joelwright-dev/nixie-clock/Assembly/SMT026051760500_B_02001476_20260529062730.jpg

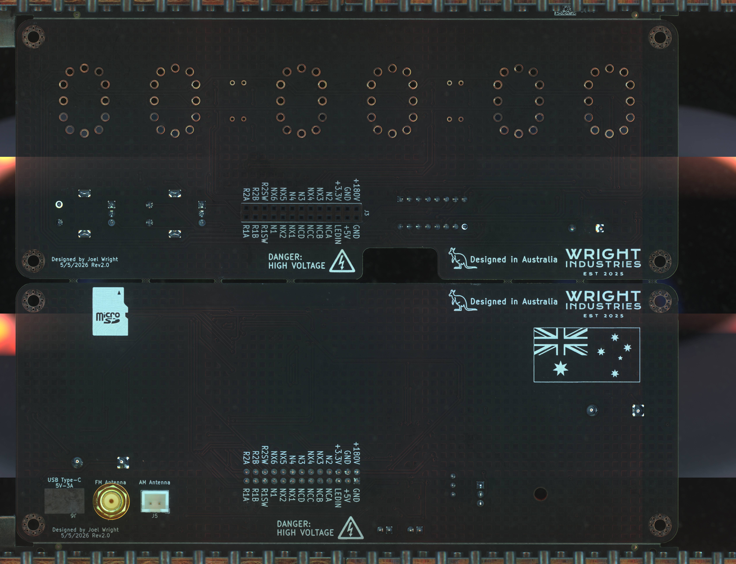
Assembly/SMT026051760500_B_02001476_20260529062730.jpg
