joelwright-dev/nixie-clock/Assembly/SMT026051760500_T_02001476_20260529062728.jpg

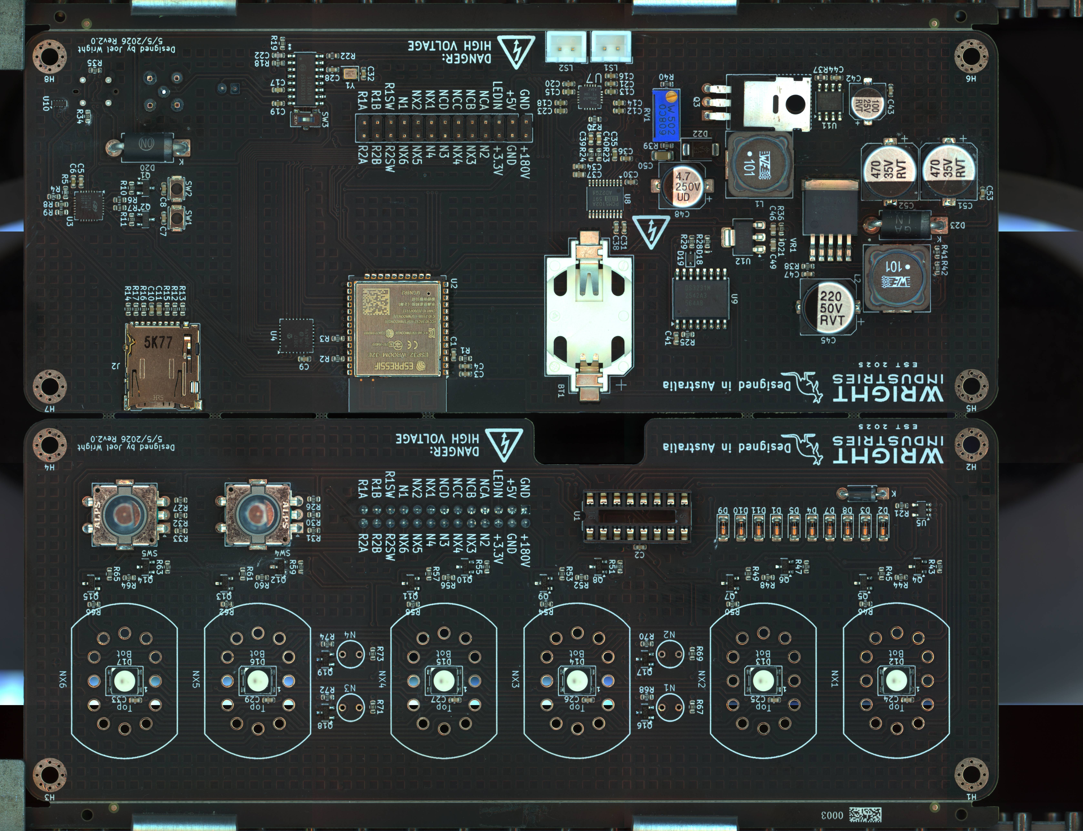
Assembly/SMT026051760500_T_02001476_20260529062728.jpg
