joelwright-dev/nixie-clock/esp32-devkitc-v4_reference_design/ESP32-DevKitC-V4_Reference_Design/README.pdf

请使⽤用以下⼯工具打开原理理图和 PCB ⽂文件 / Use the following tools to open schematics and PCB files: SCH: Cadence/OrCAD Capture V16.6
PCB: Mentor Graphics/Pads VⅩ.2

修订历史 / Revision History

- 2018.06
- 更更新原理理图和 BOM，移除 C15。更更多信息请查看 ESP32-DevKitC ⼊入⻔门指南。/ (http://esp-idf.readthedocs.io/en/latest/get-started/get-started-devkitc.html) Removed C15 from schematics and BOM list. More information can be found in ESP32-DevKitC Getting Started Guide.) (http://esp-idf.readthedocs.io/en/latest/get-started/get-started-devkitc.html)
- 增加针对 ESP32-WROOM-32D、ESP32-WROOM-32U 和 ESP32-SOLO-1 模组的 BOM。/ Added the BOM lists for modules ESP32-WROOM-32D, ESP32-WROOM-32U and ESP32-SOLO-1.
- 2018.01
- ⾸首次发布。/
First release.
