joelwright-dev/nixie-clock/SnapEDA/MAX3421EETJ_T/MAX3421EETJ_T.step

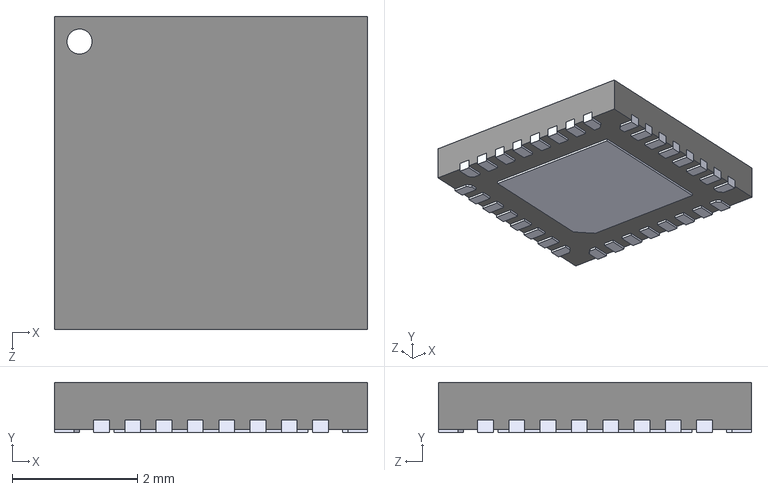
[picture p3: CAD file, 2026-06-27]
SnapEDA/MAX3421EETJ_T/MAX3421EETJ_T.step
5.00 x 0.8 x 5.00 mm
