joelwright-dev/nixie-clock/SnapEDA/TPA2016D2RTJR/TPA2016D2RTJR.step

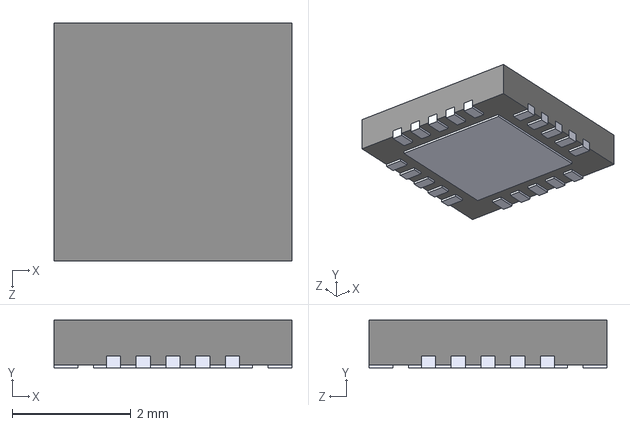
[picture p4: CAD file, 2026-04-03]
SnapEDA/TPA2016D2RTJR/TPA2016D2RTJR.step
4.00 x 0.8 x 4.00 mm
