joelwright-dev/nixie-clock/mostlydone.pdf

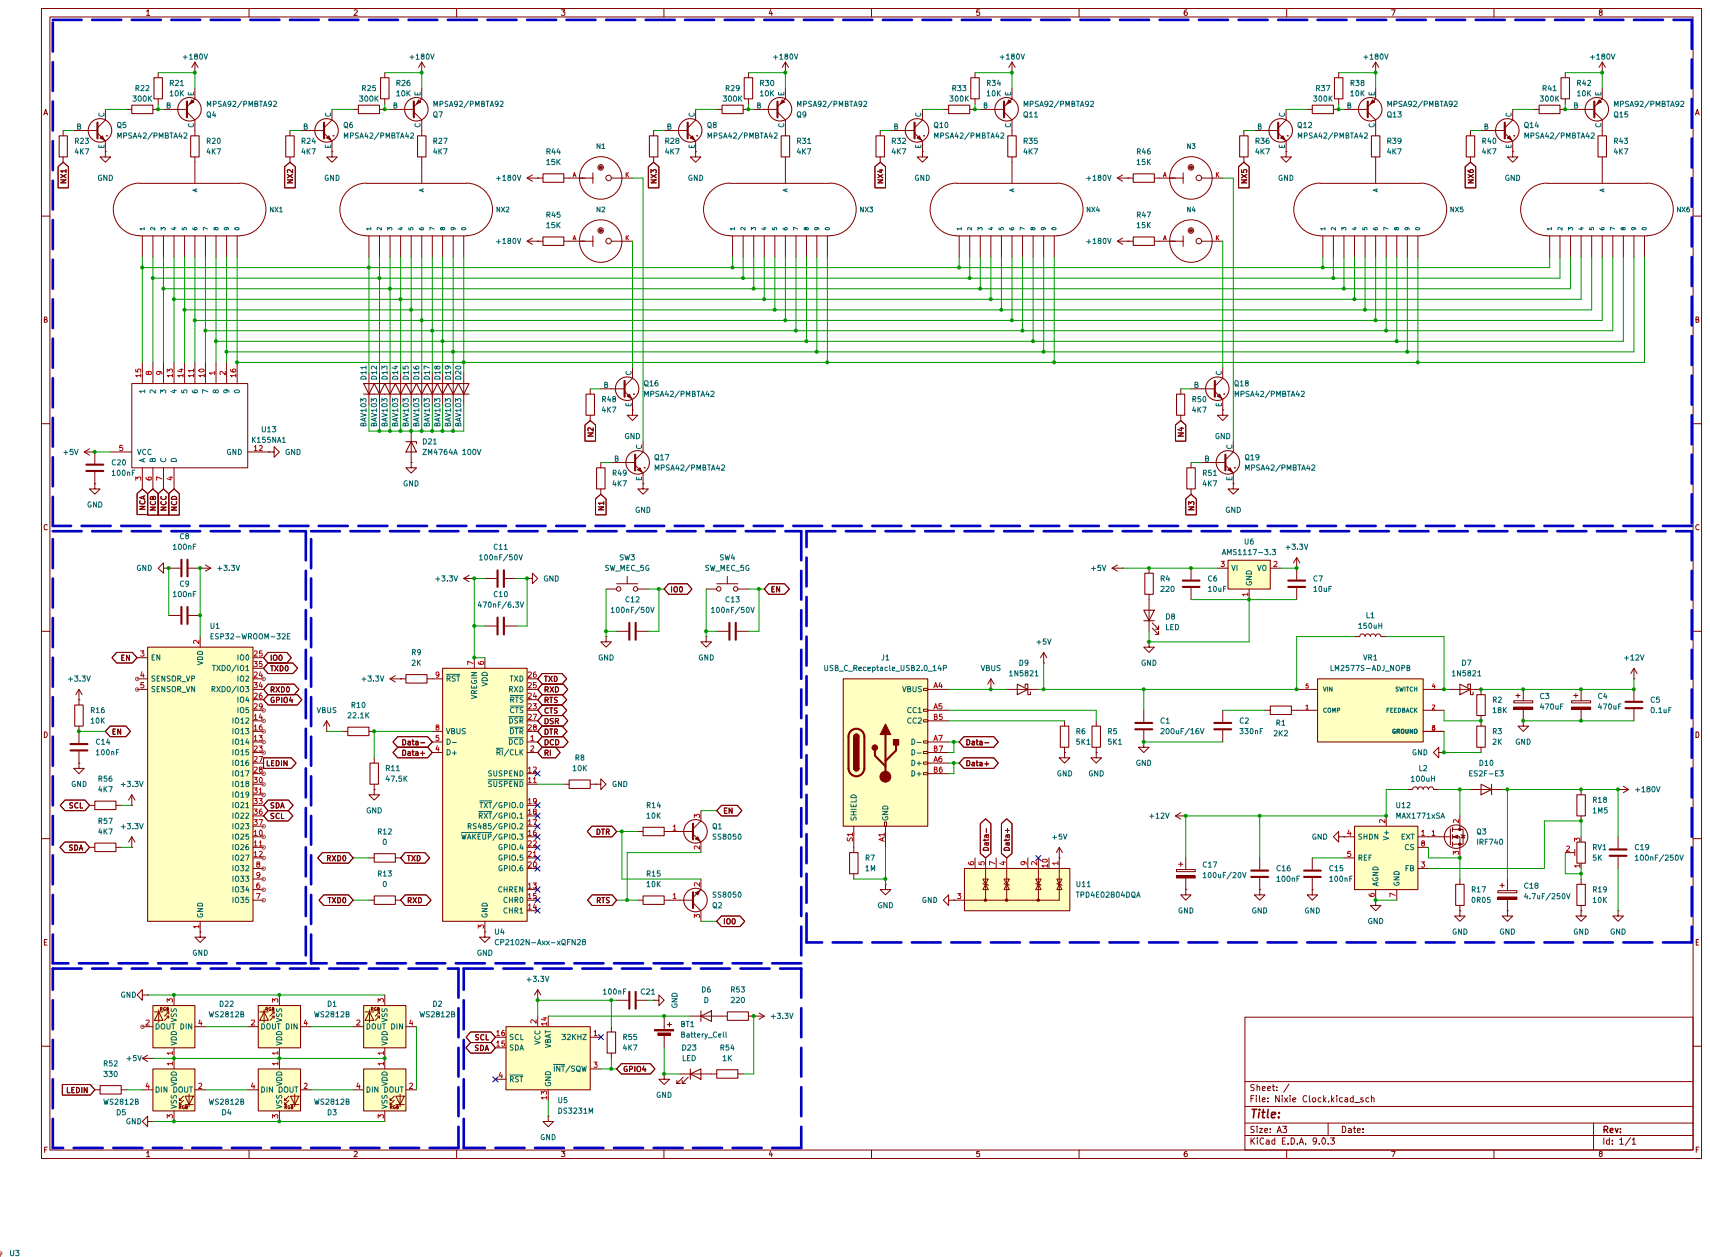
[picture p14: page 1]
