joelwright-dev/nixie-clock/(list of files, drawings)

Other design files:
esp32-devkitc-v4_reference_design/ESP32-DevKitC-V4_Reference_Design/02_PCB Layout/ESP32-DevKitC-V4_20171206A.pcb
