joelwright-dev/nixie-clock/Nixie Clock/Nixie Clock.kicad_pcb

## KiCad design Nixie Clock/Nixie Clock.kicad_pcb (2026-05-05)

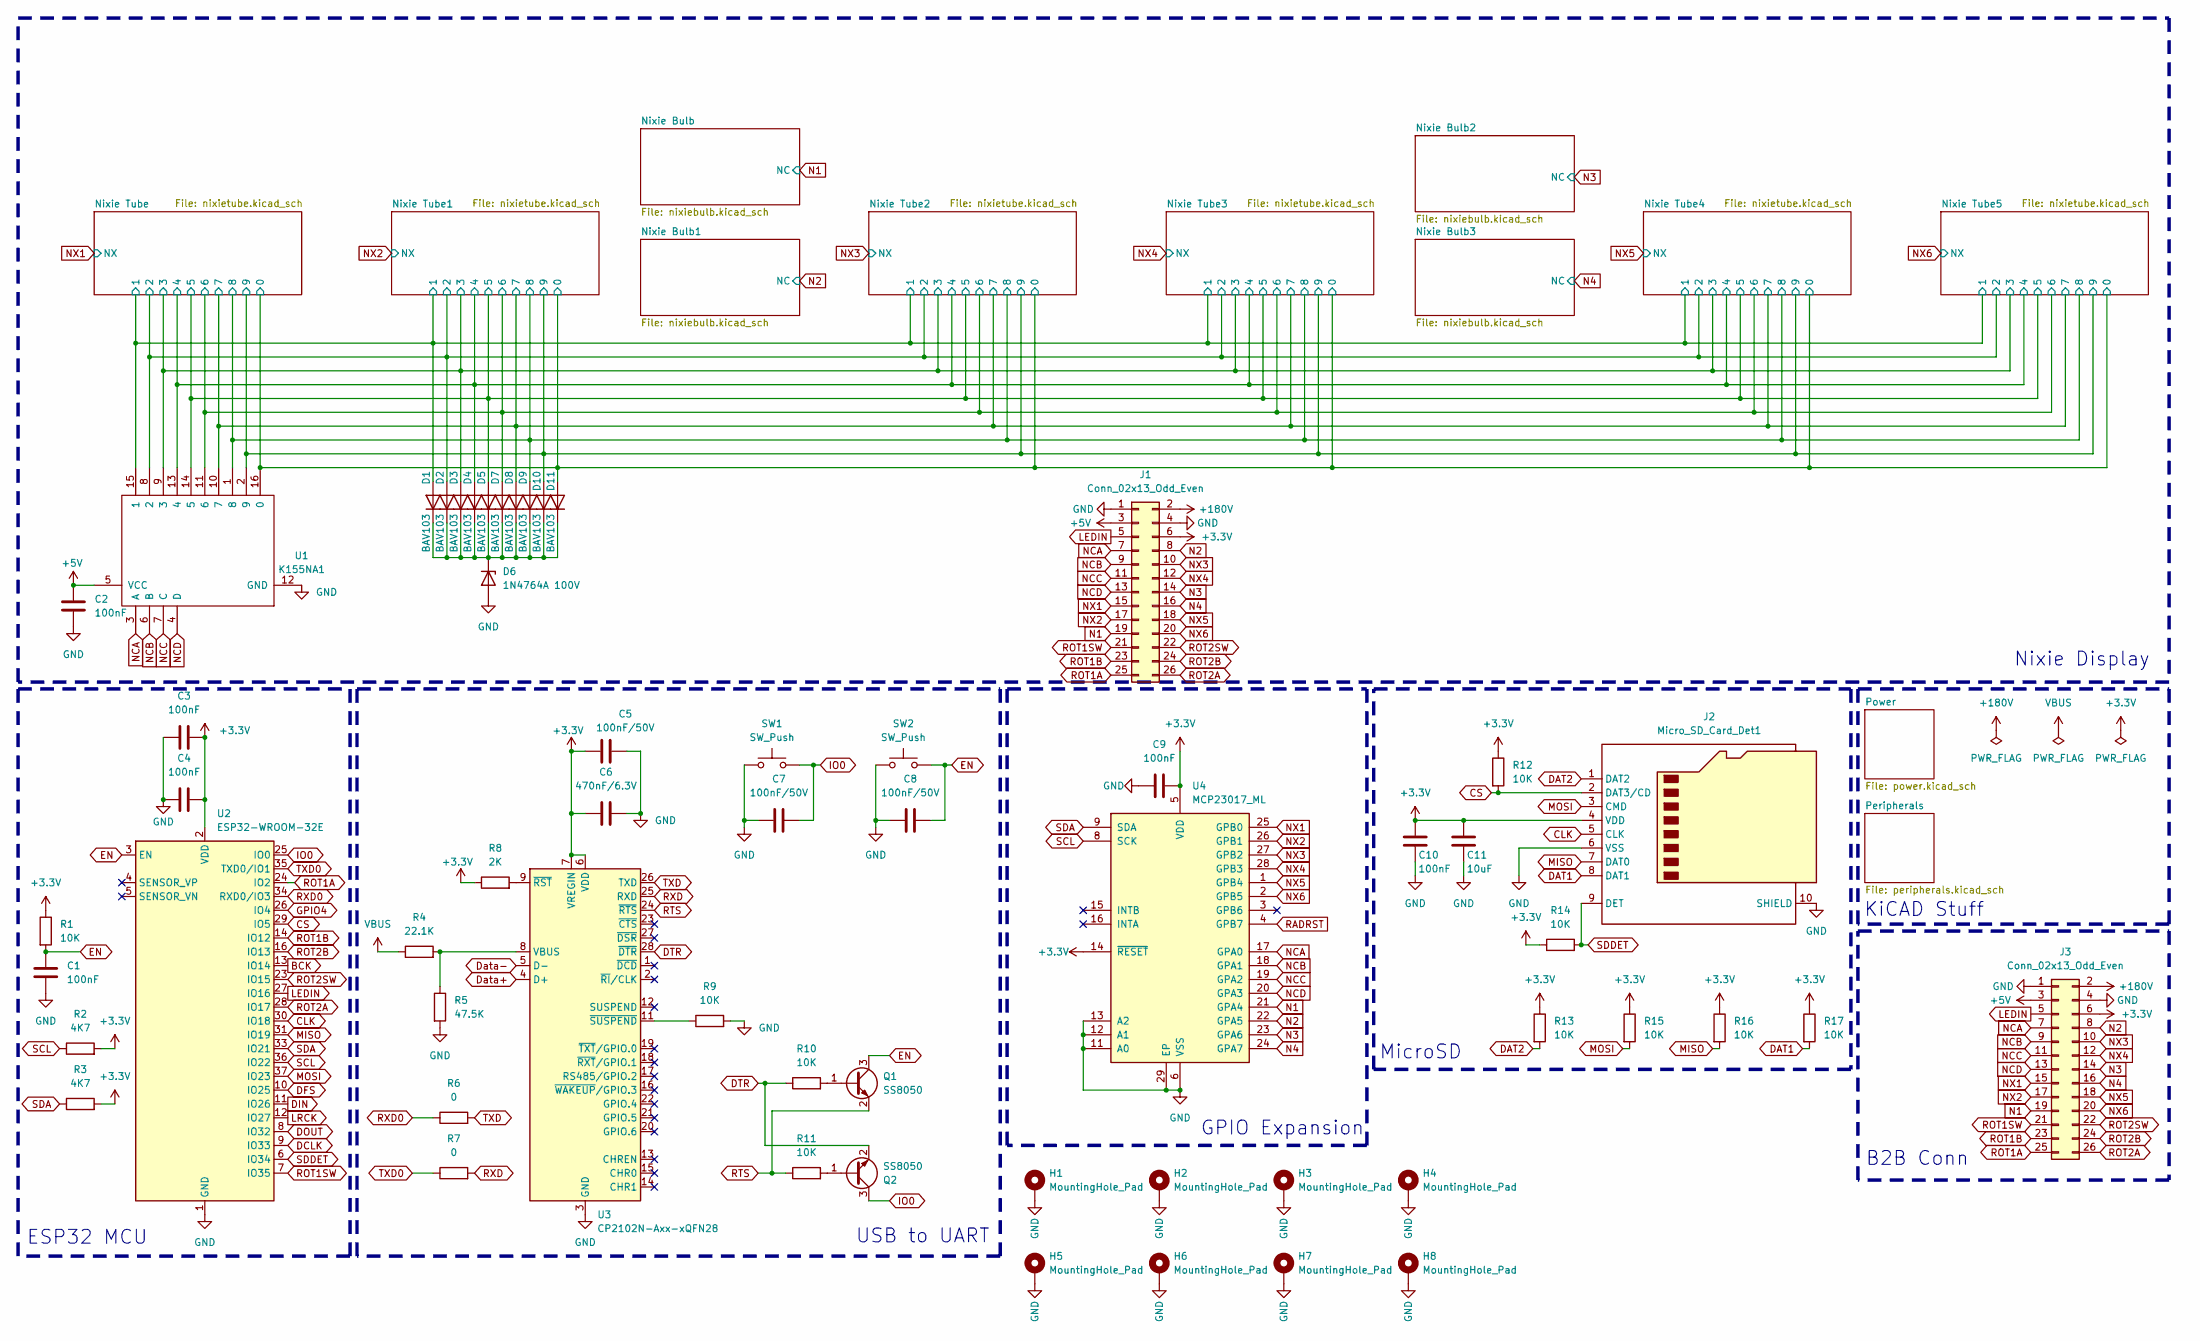
[picture p15: schematic Nixie Clock.kicad_sch]

Parts:
C1, C2, C3, C4, C9, C10: 100nF; C_0603_1608Metric
C5, C7, C8: 100nF/50V; C_0603_1608Metric
C6: 470nF/6.3V; C_0603_1608Metric
C11: 10uF; C_0603_1608Metric
D1, D2, D3, D4, D5, D7, D8, D9, D10, D11: BAV103; D_MiniMELF
D6: 1N4764A 100V; D_DO-41_SOD81_P7.62mm_Horizontal
H1, H2, H3, H4, H5, H6, H7, H8: MountingHole_Pad; MountingHole_3.2mm_M3_Pad_Via
J1: Conn_02x13_Odd_Even; PinHeader_2x13_P2.54mm_Vertical
J2: Micro_SD_Card_Det1; microSD_HC_Hirose_DM3AT-SF-PEJM5
J3: Conn_02x13_Odd_Even; PinSocket_2x13_P2.54mm_Vertical
Q1, Q2: SS8050; SOT-23
R1, R9, R10, R11, R12, R13, R14, R15, R16, R17: 10K; R_0603_1608Metric
R2, R3: 4K7; R_0603_1608Metric
R4: 22.1K; R_0603_1608Metric
R5: 47.5K; R_0603_1608Metric
R6, R7: 0; R_0603_1608Metric
R8: 2K; R_0603_1608Metric
SW1, SW2: SW_Push; SW_Push_SPST_NO_Alps_SKRK
U1: K155NA1; DIP-16_W7.62mm
U2: ESP32-WROOM-32E; ESP32-WROOM-32D
U3: CP2102N-Axx-xQFN28; QFN-28-1EP_5x5mm_P0.5mm_EP3.35x3.35mm
U4: MCP23017_ML; QFN-28-1EP_6x6mm_P0.65mm_EP4.25x4.25mm

Connections:
+3.3V: C3.2, C4.2, C5.1, C6.1, C9.2, C10.1, C11.1, J1.6, J2.4 (VDD), J3.6, R1.1, R2.2, R3.2, R8.1, R12.1, R13.1, R14.1, R15.1, R16.1, R17.1, U2.2 (VDD), U3.6 (VDD), U3.7 (VREGIN), U4.5 (VDD), U4.14 (~RESET); also elsewhere on the board
+5V: C2.1, J1.3, J3.3, U1.5 (VCC); also elsewhere on the board
+180V: J1.2, J3.2; also elsewhere on the board
/Nixie Tube/0: D11.2 (A), U1.16 (0); also elsewhere on the board
/Nixie Tube/1: D1.2 (A), U1.15 (1); also elsewhere on the board
/Nixie Tube/2: D2.2 (A), U1.8 (2); also elsewhere on the board
/Nixie Tube/3: D3.2 (A), U1.9 (3); also elsewhere on the board
/Nixie Tube/4: D4.2 (A), U1.13 (4); also elsewhere on the board
/Nixie Tube/5: D5.2 (A), U1.14 (5); also elsewhere on the board
/Nixie Tube/6: D7.2 (A), U1.11 (6); also elsewhere on the board
/Nixie Tube/7: D8.2 (A), U1.10 (7); also elsewhere on the board
/Nixie Tube/8: D9.2 (A), U1.1 (8); also elsewhere on the board
/Nixie Tube/9: D10.2 (A), U1.2 (9); also elsewhere on the board
BCK: U2.13 (IO14); also elsewhere on the board
CLK: J2.5 (CLK), U2.30 (IO18)
CS: J2.2 (DAT3/CD), R12.2, U2.29 (IO5)
DAT1: J2.8 (DAT1), R17.2
DAT2: J2.1 (DAT2), R13.2
DCLK: U2.9 (IO33); also elsewhere on the board
DFS: U2.10 (IO25); also elsewhere on the board
DIN: U2.11 (IO26); also elsewhere on the board
DOUT: U2.8 (IO32); also elsewhere on the board
DTR: Q2.2 (E), R10.1, U3.28 (~DTR)
Data+: U3.4 (D+); also elsewhere on the board
Data-: U3.5 (D-); also elsewhere on the board
EN: C1.1, C8.2, Q1.3 (C), R1.2, SW2.2, U2.3 (EN)
GND: C1.2, C2.2, C3.1, C4.1, C5.2, C6.2, C7.1, C8.1, C9.1, C10.2, C11.2, D6.2 (A), H1.1, H2.1, H3.1, H4.1, H5.1, H6.1, H7.1, H8.1, J1.1, J1.4, J2.6 (VSS), J2.10 (SHIELD), J3.1, J3.4, R5.2, R9.2, SW1.1, SW2.1, U1.12 (GND), U2.1 (GND), U2.15 (GND), U2.38 (GND), U2.39 (GND), U3.3 (GND), U3.29 (GND), U4.6 (VSS), U4.11 (A0), U4.12 (A1), U4.13 (A2), U4.29 (EP); also elsewhere on the board
GPIO4: U2.26 (IO4); also elsewhere on the board
IO0: C7.2, Q2.3 (C), SW1.2, U2.25 (IO0)
LEDIN: J1.5, J3.5, U2.27 (IO16); also elsewhere on the board
LRCK: U2.12 (IO27); also elsewhere on the board
MISO: J2.7 (DAT0), R16.2, U2.31 (IO19)
MOSI: J2.3 (CMD), R15.2, U2.37 (IO23)
N1: J1.19, J3.19, U4.21 (GPA4); also elsewhere on the board
N2: J1.8, J3.8, U4.22 (GPA5); also elsewhere on the board
N3: J1.14, J3.14, U4.23 (GPA6); also elsewhere on the board
N4: J1.16, J3.16, U4.24 (GPA7); also elsewhere on the board
NCA: J1.7, J3.7, U1.3 (A), U4.17 (GPA0)
NCB: J1.9, J3.9, U1.6 (B), U4.18 (GPA1)
NCC: J1.11, J3.11, U1.7 (C), U4.19 (GPA2)
NCD: J1.13, J3.13, U1.4 (D), U4.20 (GPA3)
NX1: J1.15, J3.15, U4.25 (GPB0); also elsewhere on the board
NX2: J1.17, J3.17, U4.26 (GPB1); also elsewhere on the board
NX3: J1.10, J3.10, U4.27 (GPB2); also elsewhere on the board
NX4: J1.12, J3.12, U4.28 (GPB3); also elsewhere on the board
NX5: J1.18, J3.18, U4.1 (GPB4); also elsewhere on the board
NX6: J1.20, J3.20, U4.2 (GPB5); also elsewhere on the board
unnamed: D1.1 (K), D2.1 (K), D3.1 (K), D4.1 (K), D5.1 (K), D6.1 (K), D7.1 (K), D8.1 (K), D9.1 (K), D10.1 (K), D11.1 (K)
unnamed: Q1.1 (B), R10.2
unnamed: Q2.1 (B), R11.2
unnamed: R4.2, R5.1, U3.8 (VBUS)
unnamed: R8.2, U3.9 (~RST)
unnamed: R9.1, U3.11 (~SUSPEND)
RADRST: U4.4 (GPB7); also elsewhere on the board
ROT1A: J1.25, J3.25, U2.24 (IO2); also elsewhere on the board
ROT1B: J1.23, J3.23, U2.14 (IO12); also elsewhere on the board
ROT1SW: J1.21, J3.21, U2.7 (IO35); also elsewhere on the board
ROT2A: J1.26, J3.26, U2.28 (IO17); also elsewhere on the board
ROT2B: J1.24, J3.24, U2.16 (IO13); also elsewhere on the board
ROT2SW: J1.22, J3.22, U2.23 (IO15); also elsewhere on the board
RTS: Q1.2 (E), R11.1, U3.24 (~RTS)
RXD: R7.2, U3.25 (RXD)
RXD0: R6.1, U2.34 (RXD0/IO3)
SCL: R2.1, U2.36 (IO22), U4.8 (SCK); also elsewhere on the board
SDA: R3.1, U2.33 (IO21), U4.9 (SDA); also elsewhere on the board
SDDET: J2.9 (DET), R14.2, U2.6 (IO34)
TXD: R6.2, U3.26 (TXD)
TXD0: R7.1, U2.35 (TXD0/IO1)
VBUS: R4.1; also elsewhere on the board

Notes on the sheet:
MicroSD
KiCAD Stuff
USB to UART
Nixie Display
B2B Conn
ESP32 MCU
GPIO Expansion

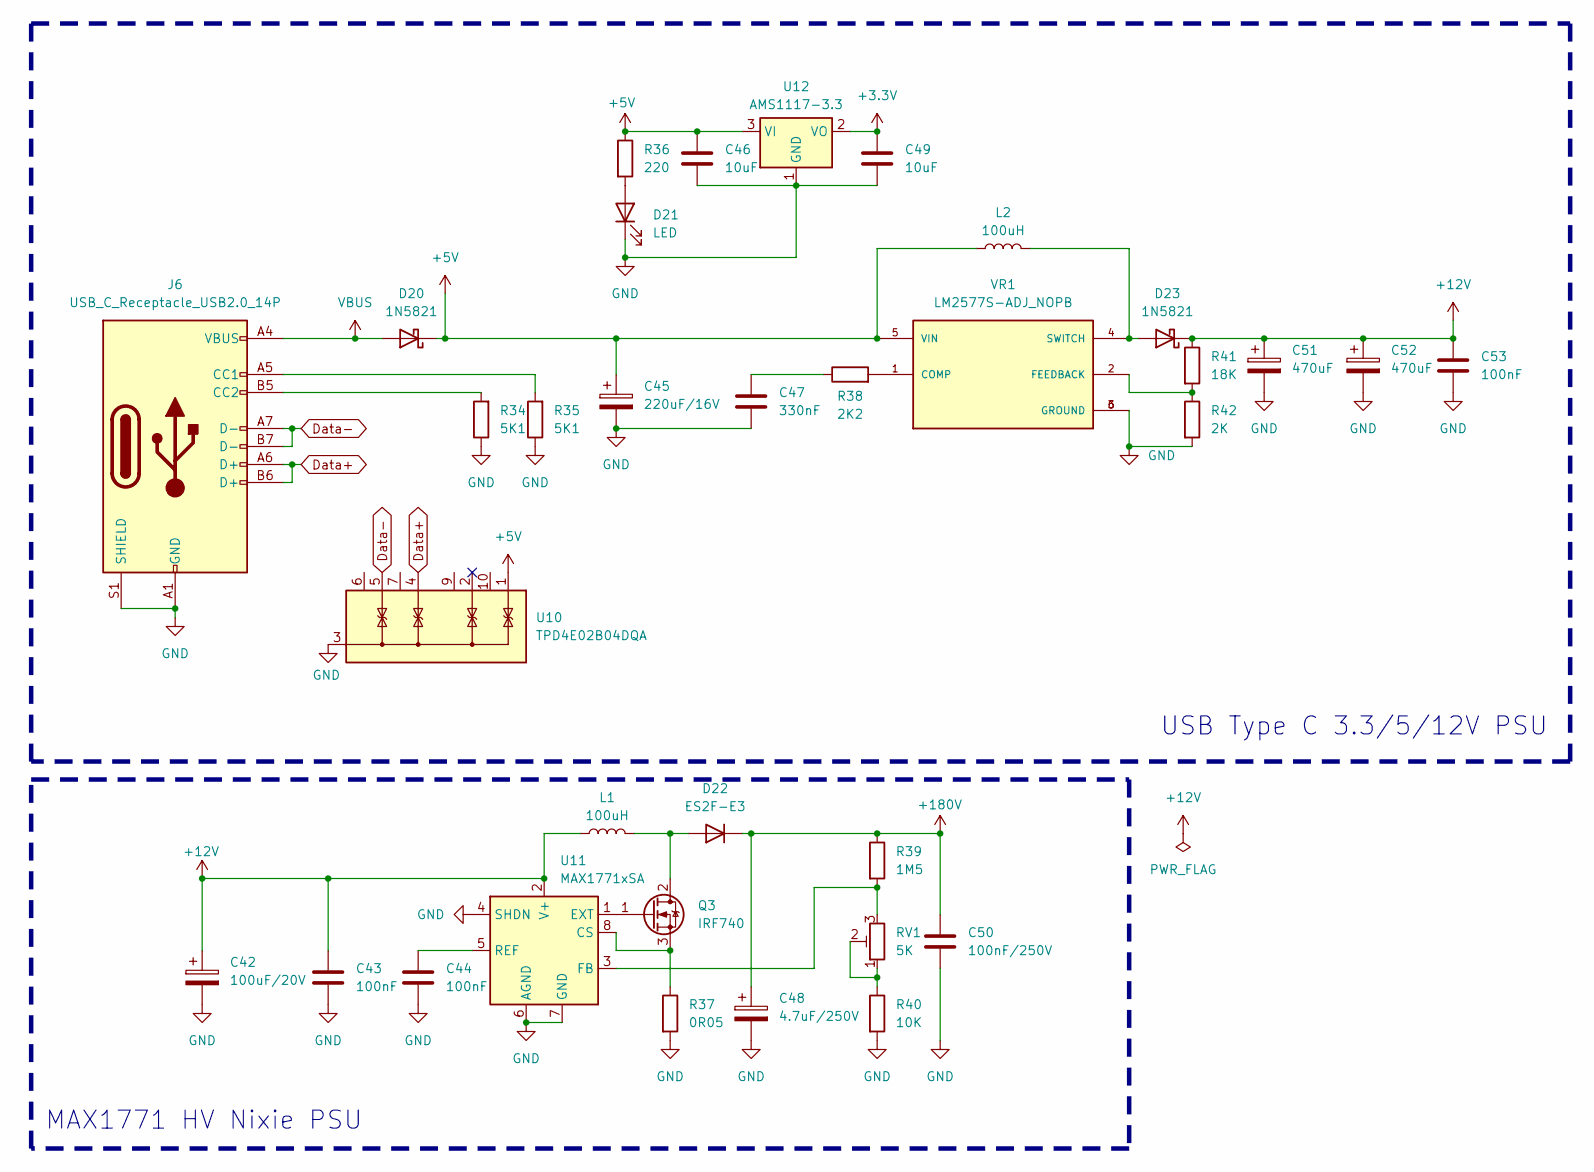
[picture p16: schematic power.kicad_sch, Nixie Clock]

Parts:
C42: 100uF/20V; CP_Elec_6.3x7.7
C43, C44, C53: 100nF; C_0603_1608Metric
C45: 220uF/16V; CP_Elec_10x10
C46, C49: 10uF; C_0603_1608Metric
C47: 330nF; C_0603_1608Metric
C48: 4.7uF/250V; CP_Elec_8x10.5
C50: 100nF/250V; C_0603_1608Metric
C51, C52: 470uF; CP_Elec_10x10.5
D20, D23: 1N5821; D_DO-201AD_P12.70mm_Horizontal
D21: LED; LED_0201_0603Metric
D22: ES2F-E3; D_SMB
J6: USB_C_Receptacle_USB2.0_14P; USB_C_Receptacle_G-Switch_GT-USB-7051x
L1, L2: 100uH; L_12x12mm_H8mm
Q3: IRF740; TO-220-3_Horizontal_TabUp
R34, R35: 5K1; R_0603_1608Metric
R36: 220; R_0603_1608Metric
R37: 0R05; R_0603_1608Metric
R38: 2K2; R_0603_1608Metric
R39: 1M5; R_0603_1608Metric
R40: 10K; R_0603_1608Metric
R41: 18K; R_0603_1608Metric
R42: 2K; R_0603_1608Metric
RV1: 5K; Potentiometer_Bourns_3296W_Vertical
U10: TPD4E02B04DQA; USON-10_2.5x1.0mm_P0.5mm
U11: MAX1771xSA; SO-8_3.9x4.9mm_P1.27mm
U12: AMS1117-3.3; SOT-223-3_TabPin2
VR1: LM2577S-ADJ_NOPB; VREG_LM2577S-ADJ_NOPB; PARTREV D

Connections:
+3.3V: C49.1, U12.2 (VO); also elsewhere on the board
+5V: C45.1, C46.1, D20.1 (K), L2.1, R36.1, U10.1 (IO1), U12.3 (VI), VR1.5 (VIN); also elsewhere on the board
+12V: C42.1, C43.1, C51.1, C52.1, C53.1, D23.1 (K), L1.1, R41.1, U11.2 (V+)
+180V: C48.1, C50.1, D22.1 (K), R39.1; also elsewhere on the board
Data+: J6.A6 (D+), J6.B6 (D+), U10.4 (IO3); also elsewhere on the board
Data-: J6.A7 (D-), J6.B7 (D-), U10.5 (IO4); also elsewhere on the board
GND: C42.2, C43.2, C44.2, C45.2, C46.2, C47.2, C48.2, C49.2, C50.2, C51.2, C52.2, C53.2, D21.1 (K), J6.A1 (GND), J6.A12 (GND), J6.B1 (GND), J6.B12 (GND), J6.S1 (SHIELD), R34.1, R35.1, R37.2, R40.2, R42.2, U10.3 (G), U10.8 (G), U11.4 (SHDN), U11.6 (AGND), U11.7 (GND), U12.1 (GND), VR1.3 (GROUND), VR1.6 (GROUND); also elsewhere on the board
unnamed: C47.1, R38.1
unnamed: D21.2 (A), R36.2
unnamed: D22.2 (A), L1.2, Q3.2 (D)
unnamed: D23.2 (A), L2.2, VR1.4 (SWITCH)
unnamed: J6.A5 (CC1), R35.2
unnamed: J6.B5 (CC2), R34.2
unnamed: Q3.1 (G), U11.1 (EXT)
unnamed: Q3.3 (S), R37.1, U11.8 (CS)
unnamed: R40.1, RV1.1, RV1.2
unnamed: R39.2, RV1.3, U11.3 (FB)
unnamed: C44.1, U11.5 (REF)
unnamed: R38.2, VR1.1 (COMP)
unnamed: R41.2, R42.1, VR1.2 (FEEDBACK)
VBUS: D20.2 (A), J6.A4 (VBUS), J6.A9 (VBUS), J6.B4 (VBUS), J6.B9 (VBUS); also elsewhere on the board

Notes on the sheet:
USB Type C 3.3/5/12V PSU
MAX1771 HV Nixie PSU

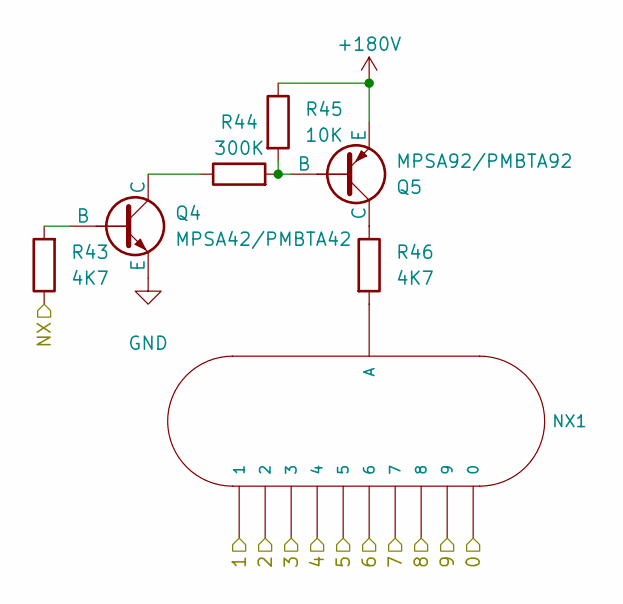
[picture p17: schematic nixietube.kicad_sch]

Parts:
NX1: IN-12A; IN-12-DSUB-NOHOLE
Q4: MPSA42/PMBTA42; SOT-23
Q5: MPSA92/PMBTA92; SOT-23
R43, R46: 4K7; R_0603_1608Metric
R44: 300K; R_0603_1608Metric
R45: 10K; R_0603_1608Metric

Connections:
+180V: Q5.3 (E), R45.1; also elsewhere on the board
/Nixie Tube/0: NX1.0; also elsewhere on the board
/Nixie Tube/1: NX1.1; also elsewhere on the board
/Nixie Tube/2: NX1.2; also elsewhere on the board
/Nixie Tube/3: NX1.3; also elsewhere on the board
/Nixie Tube/4: NX1.4; also elsewhere on the board
/Nixie Tube/5: NX1.5; also elsewhere on the board
/Nixie Tube/6: NX1.6; also elsewhere on the board
/Nixie Tube/7: NX1.7; also elsewhere on the board
/Nixie Tube/8: NX1.8; also elsewhere on the board
/Nixie Tube/9: NX1.9; also elsewhere on the board
GND: Q4.3 (E); also elsewhere on the board
NX1: R43.1; also elsewhere on the board
unnamed: NX1.A, R46.2
unnamed: Q4.2 (B), R43.2
unnamed: Q4.1 (C), R44.1
unnamed: Q5.2 (B), R44.2, R45.2
unnamed: Q5.1 (C), R46.1

Parts of its further copies:
NX2, NX3, NX4, NX5, NX6: IN-12A; IN-12-DSUB-NOHOLE
Q6, Q8, Q10, Q12, Q14: MPSA42/PMBTA42; SOT-23
Q7, Q9, Q11, Q13, Q15: MPSA92/PMBTA92; SOT-23
R47, R50, R51, R54, R55, R58, R59, R62, R63, R66: 4K7; R_0603_1608Metric
R48, R52, R56, R60, R64: 300K; R_0603_1608Metric
R49, R53, R57, R61, R65: 10K; R_0603_1608Metric

Connections of its further copies:
+180V: Q7.3 (E), Q9.3 (E), Q11.3 (E), Q13.3 (E), Q15.3 (E), R49.1, R53.1, R57.1, R61.1, R65.1; also elsewhere on the board
/Nixie Tube/0: NX2.0, NX3.0, NX4.0, NX5.0, NX6.0; also elsewhere on the board
/Nixie Tube/1: NX2.1, NX3.1, NX4.1, NX5.1, NX6.1; also elsewhere on the board
/Nixie Tube/2: NX2.2, NX3.2, NX4.2, NX5.2, NX6.2; also elsewhere on the board
/Nixie Tube/3: NX2.3, NX3.3, NX4.3, NX5.3, NX6.3; also elsewhere on the board
/Nixie Tube/4: NX2.4, NX3.4, NX4.4, NX5.4, NX6.4; also elsewhere on the board
/Nixie Tube/5: NX2.5, NX3.5, NX4.5, NX5.5, NX6.5; also elsewhere on the board
/Nixie Tube/6: NX2.6, NX3.6, NX4.6, NX5.6, NX6.6; also elsewhere on the board
/Nixie Tube/7: NX2.7, NX3.7, NX4.7, NX5.7, NX6.7; also elsewhere on the board
/Nixie Tube/8: NX2.8, NX3.8, NX4.8, NX5.8, NX6.8; also elsewhere on the board
/Nixie Tube/9: NX2.9, NX3.9, NX4.9, NX5.9, NX6.9; also elsewhere on the board
GND: Q6.3 (E), Q8.3 (E), Q10.3 (E), Q12.3 (E), Q14.3 (E); also elsewhere on the board
NX2: R47.1; also elsewhere on the board
NX3: R51.1; also elsewhere on the board
NX4: R55.1; also elsewhere on the board
NX5: R59.1; also elsewhere on the board
NX6: R63.1; also elsewhere on the board
unnamed: NX2.A, R50.2
unnamed: NX3.A, R54.2
unnamed: NX4.A, R58.2
unnamed: NX5.A, R62.2
unnamed: NX6.A, R66.2
unnamed: Q6.2 (B), R47.2
unnamed: Q6.1 (C), R48.1
unnamed: Q7.2 (B), R48.2, R49.2
unnamed: Q7.1 (C), R50.1
unnamed: Q8.2 (B), R51.2
unnamed: Q8.1 (C), R52.1
unnamed: Q9.2 (B), R52.2, R53.2
unnamed: Q9.1 (C), R54.1
unnamed: Q10.2 (B), R55.2
unnamed: Q10.1 (C), R56.1
unnamed: Q11.2 (B), R56.2, R57.2
unnamed: Q11.1 (C), R58.1
unnamed: Q12.2 (B), R59.2
unnamed: Q12.1 (C), R60.1
unnamed: Q13.2 (B), R60.2, R61.2
unnamed: Q13.1 (C), R62.1
unnamed: Q14.2 (B), R63.2
unnamed: Q14.1 (C), R64.1
unnamed: Q15.2 (B), R64.2, R65.2
unnamed: Q15.1 (C), R66.1

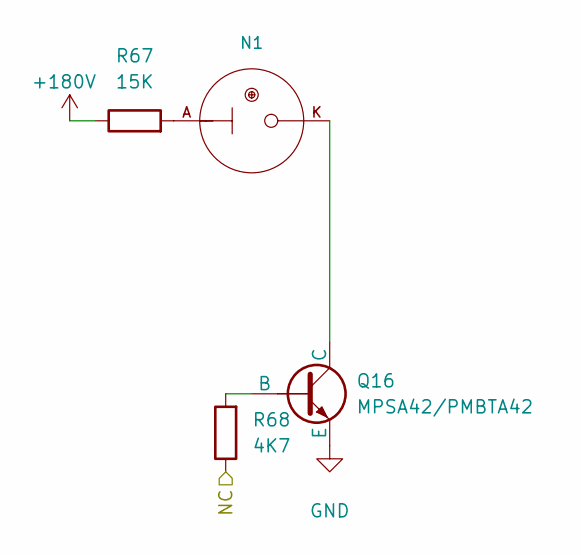
[picture p18: schematic nixiebulb.kicad_sch]

Parts:
N1: IN-6
Q16: MPSA42/PMBTA42; SOT-23
R67: 15K; R_0603_1608Metric
R68: 4K7; R_0603_1608Metric

Connections:
+180V: R67.1; also elsewhere on the board
GND: Q16.3 (E); also elsewhere on the board
N1: R68.1; also elsewhere on the board
unnamed: N1.A, R67.2
unnamed: Q16.2 (B), R68.2
unnamed: N1.K, Q16.1 (C)

Parts of its further copies:
N2, N3, N4: IN-6
Q17, Q18, Q19: MPSA42/PMBTA42; SOT-23
R69, R71, R73: 15K; R_0603_1608Metric
R70, R72, R74: 4K7; R_0603_1608Metric

Connections of its further copies:
+180V: R69.1, R71.1, R73.1; also elsewhere on the board
GND: Q17.3 (E), Q18.3 (E), Q19.3 (E); also elsewhere on the board
N2: R70.1; also elsewhere on the board
N3: R72.1; also elsewhere on the board
N4: R74.1; also elsewhere on the board
unnamed: N2.A, R69.2
unnamed: N3.A, R71.2
unnamed: N4.A, R73.2
unnamed: Q17.2 (B), R70.2
unnamed: N2.K, Q17.1 (C)
unnamed: Q18.2 (B), R72.2
unnamed: N3.K, Q18.1 (C)
unnamed: Q19.2 (B), R74.2
unnamed: N4.K, Q19.1 (C)

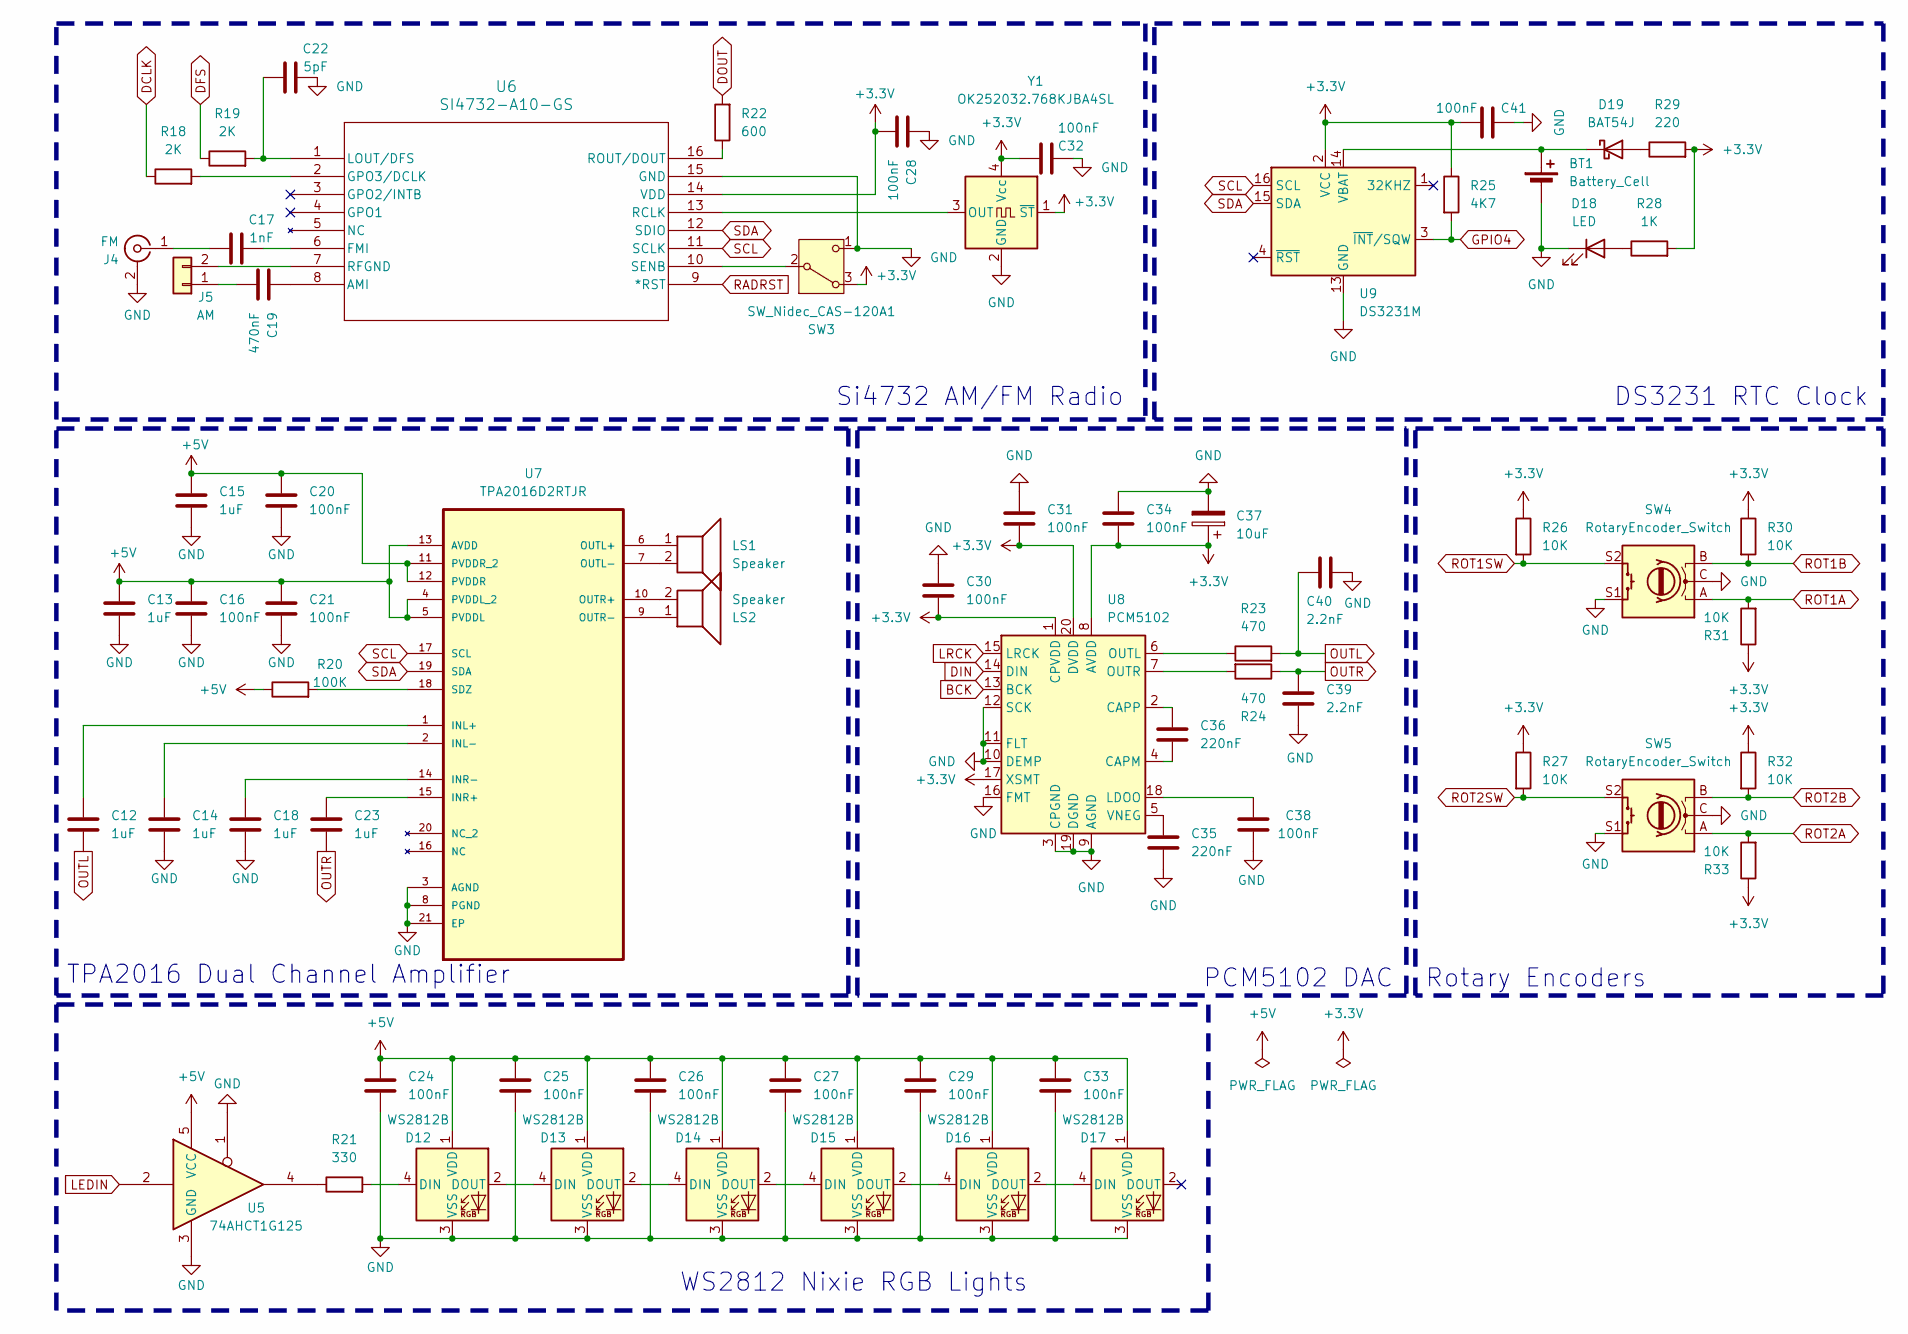
[picture p19: schematic peripherals.kicad_sch, Nixie Clock]

Parts:
BT1: Battery_Cell; BatteryHolder_Keystone_1060_1x2032
C12, C13, C14, C15, C18, C23: 1uF; C_0603_1608Metric
C16, C20, C21, C24, C25, C26, C27, C28, C29, C30, C31, C32, C33, C34, C38, C41: 100nF; C_0603_1608Metric
C17: 1nF; C_0603_1608Metric
C19: 470nF; C_0603_1608Metric
C22: 5pF; C_0603_1608Metric
C35, C36: 220nF; C_0603_1608Metric
C37: 10uF; C_0603_1608Metric
C39, C40: 2.2nF; C_0603_1608Metric
D12, D13, D14, D15, D16, D17: WS2812B; LED_WS2812B_PLCC4_5.0x5.0mm_P3.2mm
D18: LED; LED_0201_0603Metric
D19: BAT54J; D_SOD-323F
J4: FM; SMA_Amphenol_901-144_Vertical
J5: AM; JST_XH_B2B-XH-A_1x02_P2.50mm_Vertical
LS1, LS2: Speaker; JST_XH_B2B-XH-A_1x02_P2.50mm_Vertical
R18, R19: 2K; R_0603_1608Metric
R20: 100K; R_0603_1608Metric
R21: 330; R_0603_1608Metric
R22: 600; R_0603_1608Metric
R23, R24: 470; R_0603_1608Metric
R25: 4K7; R_0603_1608Metric
R26, R27, R30, R31, R32, R33: 10K; R_0603_1608Metric
R28: 1K; R_0603_1608Metric
R29: 220; R_0603_1608Metric
SW3: SW_Nidec_CAS-120A1; Nidec_Copal_CAS-120A
SW4, SW5: RotaryEncoder_Switch; RotaryEncoder_Alps_EC11E-Switch_Vertical_H20mm
U5: 74AHCT1G125; SOT-23-5
U6: SI4732-A10-GS; SOIC_A10-GS_SIL
U7: TPA2016D2RTJR; QFN50P400X400X80-21N; MPN TPA2016D2RTJR
U8: PCM5102; TSSOP-20_4.4x6.5mm_P0.65mm
U9: DS3231M; SOIC-16W_7.5x10.3mm_P1.27mm
Y1: OK252032.768KJBA4SL; Oscillator_SMD_SeikoEpson_SG210-4Pin_2.5x2.0mm

Connections:
+3.3V: C28.2, C30.1, C31.1, C32.2, C34.1, C37.1, C41.2, R25.1, R26.1, R27.1, R28.2, R29.2, R30.1, R31.1, R32.1, R33.1, SW3.3 (A), U6.14 (VDD), U8.1 (CPVDD), U8.8 (AVDD), U8.17 (XSMT), U8.20 (DVDD), U9.2 (VCC), Y1.1 (~ST), Y1.4 (Vcc); also elsewhere on the board
+5V: C13.2, C15.2, C16.2, C20.2, C21.2, C24.1, C25.1, C26.1, C27.1, C29.1, C33.1, D12.1 (VDD), D13.1 (VDD), D14.1 (VDD), D15.1 (VDD), D16.1 (VDD), D17.1 (VDD), R20.1, U5.5 (VCC), U7.4 (PVDDL_2), U7.5 (PVDDL), U7.11 (PVDDR_2), U7.12 (PVDDR), U7.13 (AVDD); also elsewhere on the board
BCK: U8.13 (BCK); also elsewhere on the board
DCLK: R18.1; also elsewhere on the board
DFS: R19.1; also elsewhere on the board
DIN: U8.14 (DIN); also elsewhere on the board
DOUT: R22.2; also elsewhere on the board
GND: BT1.2 (-), C13.1, C14.1, C15.1, C16.1, C18.1, C20.1, C21.1, C22.1, C24.2, C25.2, C26.2, C27.2, C28.1, C29.2, C30.2, C31.2, C32.1, C33.2, C34.2, C35.2, C37.2, C38.2, C39.2, C40.1, C41.1, D12.3 (VSS), D13.3 (VSS), D14.3 (VSS), D15.3 (VSS), D16.3 (VSS), D17.3 (VSS), D18.1 (K), J4.2 (Ext), SW3.1 (C), SW4.C, SW4.S1, SW5.C, SW5.S1, U5.1, U5.3 (GND), U6.15 (GND), U7.3 (AGND), U7.8 (PGND), U7.21 (EP), U8.3 (CPGND), U8.9 (AGND), U8.10 (DEMP), U8.11 (FLT), U8.12 (SCK), U8.16 (FMT), U8.19 (DGND), U9.5 (GND), U9.6 (GND), U9.7 (GND), U9.8 (GND), U9.9 (GND), U9.10 (GND), U9.11 (GND), U9.12 (GND), U9.13 (GND), Y1.2 (GND); also elsewhere on the board
GPIO4: R25.2, U9.3 (~INT/SQW); also elsewhere on the board
LEDIN: U5.2; also elsewhere on the board
LRCK: U8.15 (LRCK); also elsewhere on the board
unnamed: BT1.1 (+), D19.1 (K), U9.14 (VBAT)
unnamed: D12.4 (DIN), R21.2
unnamed: D12.2 (DOUT), D13.4 (DIN)
unnamed: D13.2 (DOUT), D14.4 (DIN)
unnamed: D14.2 (DOUT), D15.4 (DIN)
unnamed: D15.2 (DOUT), D16.4 (DIN)
unnamed: D16.2 (DOUT), D17.4 (DIN)
unnamed: D18.2 (A), R28.1
unnamed: D19.2 (A), R29.1
unnamed: C17.2, J4.1 (In)
unnamed: C19.2, J5.1
unnamed: J5.2, U6.7 (RFGND)
unnamed: R21.1, U5.4
unnamed: SW3.2 (B), U6.10 (SENB)
unnamed: C19.1, U6.8 (AMI)
unnamed: C17.1, U6.6 (FMI)
unnamed: R18.2, U6.2 (GPO3/DCLK)
unnamed: C22.2, R19.2, U6.1 (LOUT/DFS)
unnamed: U6.13 (RCLK), Y1.3 (OUT)
unnamed: R22.1, U6.16 (ROUT/DOUT)
unnamed: C12.2, U7.1 (INL+)
unnamed: C14.2, U7.2 (INL-)
unnamed: C23.2, U7.15 (INR+)
unnamed: C18.2, U7.14 (INR-)
unnamed: LS1.1, U7.6 (OUTL+)
unnamed: LS1.2, U7.7 (OUTL-)
unnamed: LS2.2, U7.10 (OUTR+)
unnamed: LS2.1, U7.9 (OUTR-)
unnamed: R20.2, U7.18 (SDZ)
unnamed: C36.2, U8.4 (CAPM)
unnamed: C36.1, U8.2 (CAPP)
unnamed: C38.1, U8.18 (LDOO)
unnamed: R23.1, U8.6 (OUTL)
unnamed: R24.2, U8.7 (OUTR)
unnamed: C35.1, U8.5 (VNEG)
OUTL: C12.1, C40.2, R23.2
OUTR: C23.1, C39.1, R24.1
RADRST: U6.9 (*RST); also elsewhere on the board
ROT1A: R31.2, SW4.A; also elsewhere on the board
ROT1B: R30.2, SW4.B; also elsewhere on the board
ROT1SW: R26.2, SW4.S2; also elsewhere on the board
ROT2A: R33.2, SW5.A; also elsewhere on the board
ROT2B: R32.2, SW5.B; also elsewhere on the board
ROT2SW: R27.2, SW5.S2; also elsewhere on the board
SCL: U6.11 (SCLK), U7.17 (SCL), U9.16 (SCL); also elsewhere on the board
SDA: U6.12 (SDIO), U7.19 (SDA), U9.15 (SDA); also elsewhere on the board

Notes on the sheet:
Si4732 AM/FM Radio
TPA2016 Dual Channel Amplifier
PCM5102 DAC
DS3231 RTC Clock
WS2812 Nixie RGB Lights
Rotary Encoders

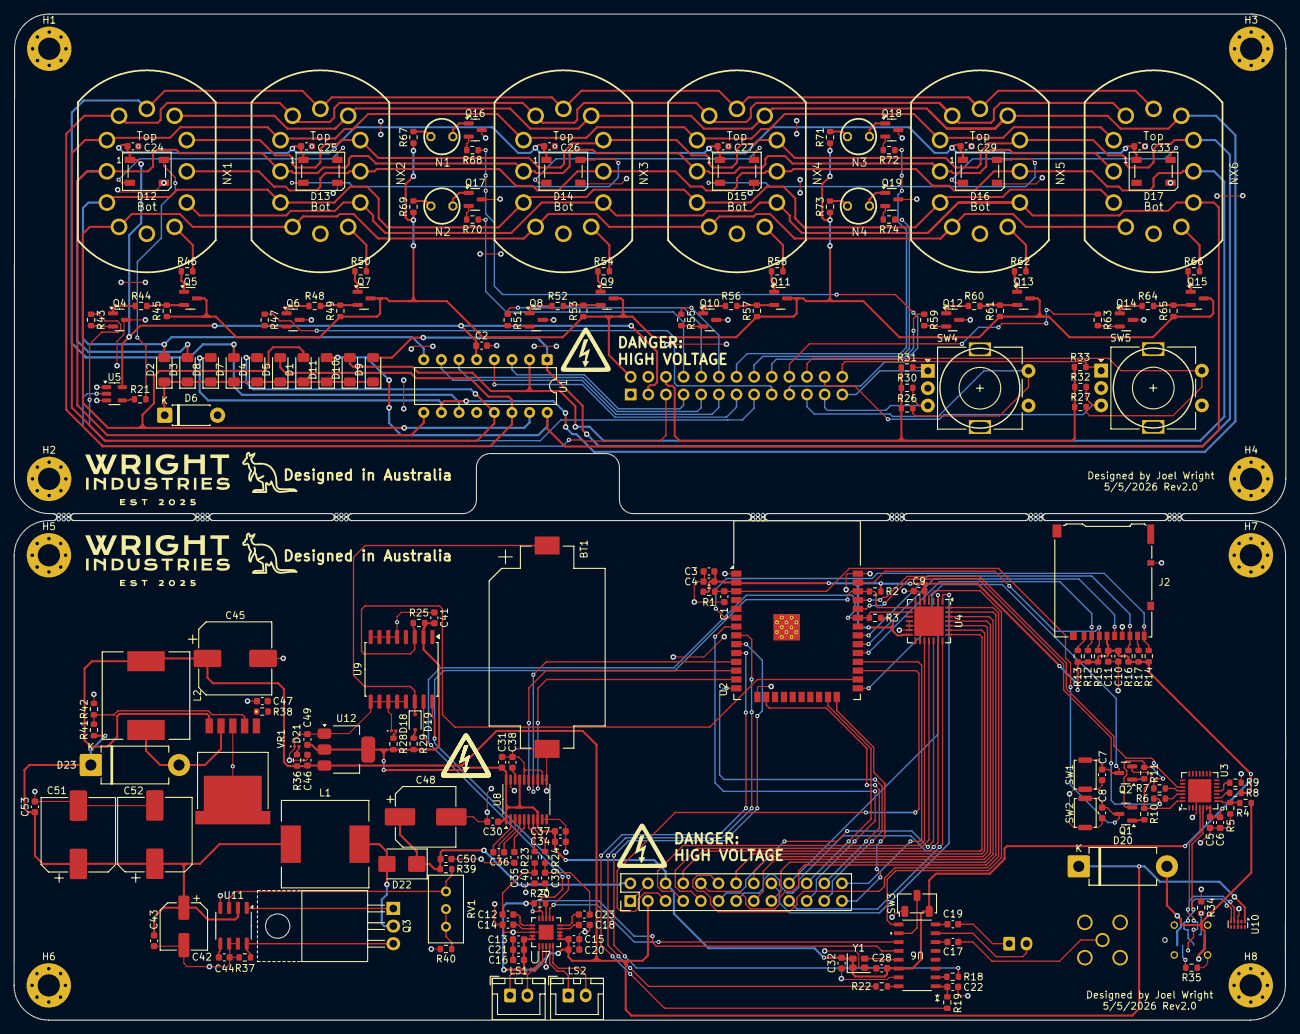
[picture p20: board Nixie Clock.kicad_pcb from above]

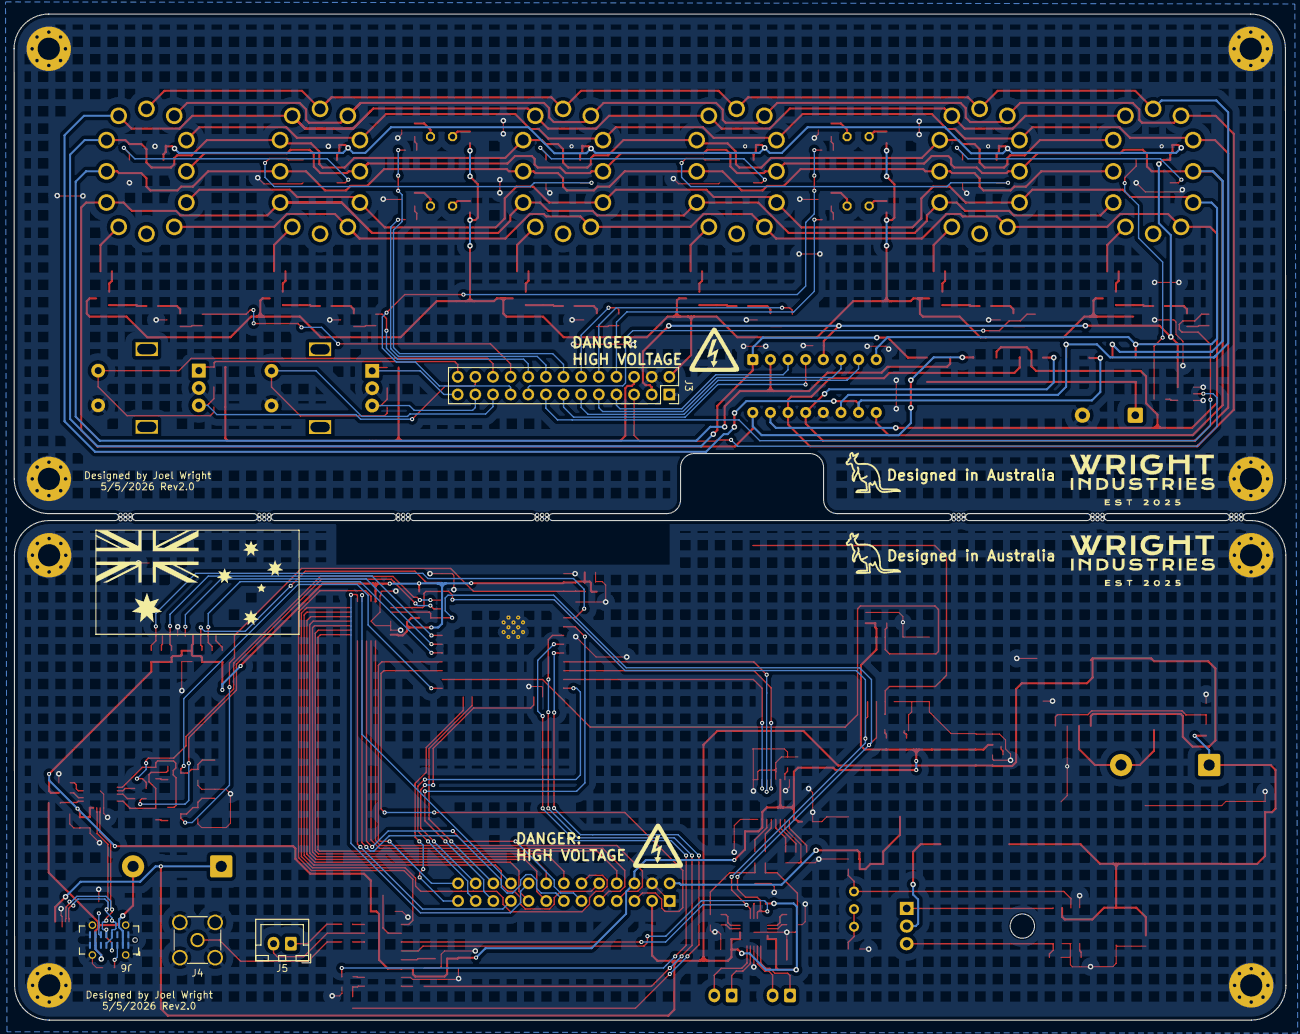
[picture p21: board Nixie Clock.kicad_pcb from below]

Board: 2 copper layers, 183.2 x 144.9 mm, 225 parts (4 on the bottom side), 162 nets.

Other parts of the board:
mouse-bite-1mm-3mm, mouse-bite-1mm-3mm#2, mouse-bite-1mm-3mm#3, mouse-bite-1mm-3mm#4, mouse-bite-1mm-3mm#5, mouse-bite-1mm-3mm#6, mouse-bite-1mm-3mm#7: VAL**; mouse-bite-1mm-3mm
