joelwright-dev/nixie-clock/(commit log)

2026-05-05 PCB routed
    [Nixie Clock.kicad_pcb, Nixie Clock.kicad_sch, Nixie Clock_backup.kicad_pcb, nixiebulb.kicad_sch, nixietube.kicad_sch, peripherals.kicad_sch, power.kicad_sch]
2026-05-06 Update footprints
2026-05-24 Rev2.1 depopulated R30 and R31 pullup resistors
    [BOM-Nixie Clock.csv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]
2026-06-17 change R37 and R39 to higher rated resistors
    [power.kicad_sch]
2026-06-27 Add MAX3421 and CH334R for mass storage device capability
    [MAX3421EETJ_T.step, Nixie Clock.kicad_sch]
2026-06-27 Route PCB rev2.1
    [Nixie Clock.kicad_sch]
2026-06-27 Generated gerbers
    [BOM-Nixie Clock.csv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]
2026-06-28 Add capacitor across R39 for filtering
    [power.kicad_sch]
